KostarevVI/rehab-device/Arduino Program/Sector.h

#pragma once
#include <Arduino.h>

#define val_matrix_len 43  // initially 51 (was decreased due to redundant zeroes)
const PROGMEM float val_matrix[val_matrix_len][val_matrix_len] = {
  {1.00, 1.00, 1.00, 1.00, 1.00, 1.00, 1.00, 1.00, 1.00, 1.00, 1.00, 1.00, 1.00, 1.00, 1.00, 0.95, 0.88, 0.82, 0.76, 0.70, 0.64, 0.58, 0.53, 0.47, 0.42, 0.38, 0.33, 0.29, 0.25, 0.21, 0.18, 0.15, 0.12, 0.10, 0.08, 0.06, 0.05, 0.04, 0.03, 0.02, 0.01, 0.01, 0.01}, 
  {1.00, 1.00, 1.00, 1.00, 1.00, 1.00, 1.00, 1.00, 1.00, 1.00, 1.00, 1.00, 1.00, 1.00, 1.00, 0.94, 0.88, 0.82, 0.76, 0.70, 0.64, 0.58, 0.53, 0.47, 0.42, 0.37, 0.33, 0.29, 0.25, 0.21, 0.18, 0.15, 0.12, 0.10, 0.08, 0.06, 0.05, 0.04, 0.03, 0.02, 0.01, 0.01, 0.01}, 
  {1.00, 1.00, 1.00, 1.00, 1.00, 1.00, 1.00, 1.00, 1.00, 1.00, 1.00, 1.00, 1.00, 1.00, 1.00, 0.94, 0.88, 0.82, 0.76, 0.70, 0.64, 0.58, 0.52, 0.47, 0.42, 0.37, 0.33, 0.28, 0.25, 0.21, 0.18, 0.15, 0.12, 0.10, 0.08, 0.06, 0.05, 0.04, 0.03, 0.02, 0.01, 0.01, 0.01}, 
  {1.00, 1.00, 1.00, 1.00, 1.00, 1.00, 1.00, 1.00, 1.00, 1.00, 1.00, 1.00, 1.00, 1.00, 0.99, 0.93, 0.87, 0.81, 0.75, 0.69, 0.63, 0.57, 0.52, 0.47, 0.42, 0.37, 0.32, 0.28, 0.24, 0.21, 0.18, 0.15, 0.12, 0.10, 0.08, 0.06, 0.05, 0.04, 0.03, 0.02, 0.01, 0.01, 0.01}, 
  {1.00, 1.00, 1.00, 1.00, 1.00, 1.00, 1.00, 1.00, 1.00, 1.00, 1.00, 1.00, 1.00, 1.00, 0.97, 0.92, 0.86, 0.80, 0.74, 0.68, 0.62, 0.57, 0.51, 0.46, 0.41, 0.36, 0.32, 0.28, 0.24, 0.21, 0.17, 0.15, 0.12, 0.10, 0.08, 0.06, 0.05, 0.04, 0.03, 0.02, 0.01, 0.01, 0.01}, 
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
    int radius;
    int x_center;
    int y_center;
    byte pos;
    float norm_factor;
};

Sector::Sector(){}

Sector::Sector(int x, int y, int r, byte p){
  radius = r;
  x_center = x;
  y_center = y;
  pos = p;
  norm_factor = 0.05042; //float(val_matrix_len - 1) / radius == 35 / 989
}


uint16_t Sector::getPwmTime(int x, int y, int pot_value_mapped){
  
  if(abs(x - x_center) > radius || abs(y - y_center) > radius){
    return 0;
  } else {
    int row = float(abs(abs(x) - abs(x_center))) * norm_factor;
    int column = float(abs(abs(y) - abs(y_center))) * norm_factor;
    float float_val = pgm_read_float(&val_matrix[row][column]);
    
//    Serial.println(pos + String(" ") + float_val + String(" ") + row + String(" ") + column + String(" ") + x + String(" ") + x_center + String(" ") + y + String(" ") + y_center); // Debug
    return 4 * int(float(pot_value_mapped) * float(float_val) + 0.5);
  }
}
